devanmcg/FireScienceDIY/README.md

# FireScienceDIY
Materials to support the do-it-yourselfer in conducting robust wildland fire science.
