devanmcg/FireScienceDIY/script/README.md

# FireScienceDIY scripts

Useful scripts for the wildland fire scientist that should probably someday be made into a package. 

## `GetHeatingCurves.R`

As described [in this blog post](https://diyfirescience.info/portfolio/work6/), allows users to interact graphically with temperature-time data from thermocouple dataloggers to pull heating curves from the rest of the logged data.
