devanmcg/FireScienceDIY/FeatherFlame/PCB/README.md

# CAD-type files for FeatherFlame PCB

[Place an order on OSH Park](https://oshpark.com/shared_projects/cAXzsQJw)
