devanmcg/FireScienceDIY/(list of files, drawings)

Other design files:
FeatherFlame/PCB/FeatherFlame6tc.fzz
