devanmcg/FireScienceDIY/(commit log)

2020-05-18 add arduino script
2020-05-18 add FeatherFlame folder
    [design_export.gbl, design_export.gbo, design_export.gbp, design_export.gbs, design_export.gko, design_export.gtl, design_export.gto, design_export.gtp]
2020-05-22 Add Oakville example
    [FeatherFlame6tc.fzz]
2020-12-02 add MZ data
    [2019_FuelMoistureData.xlsx, AllLocations.xlsx, Fire_Behavior_Weather_All.xlsx, HREC_FireBehavior_Data_MZ.xlsx, MZdataFeb2020.xlsx, ThermocoupleData.csv, UniqueCodes.xlsx, weather.xlsx]
2021-02-02 Remove SpatialFireBehavior
    [2019_FuelMoistureData.xlsx, AllLocations.xlsx, Fire_Behavior_Weather_All.xlsx, HREC_FireBehavior_Data_MZ.xlsx, ThermocoupleData.csv, UniqueCodes.xlsx, weather.xlsx]
